miklobit/graffitiRobot/SolidWorksModel/Ensamble.SLDASM

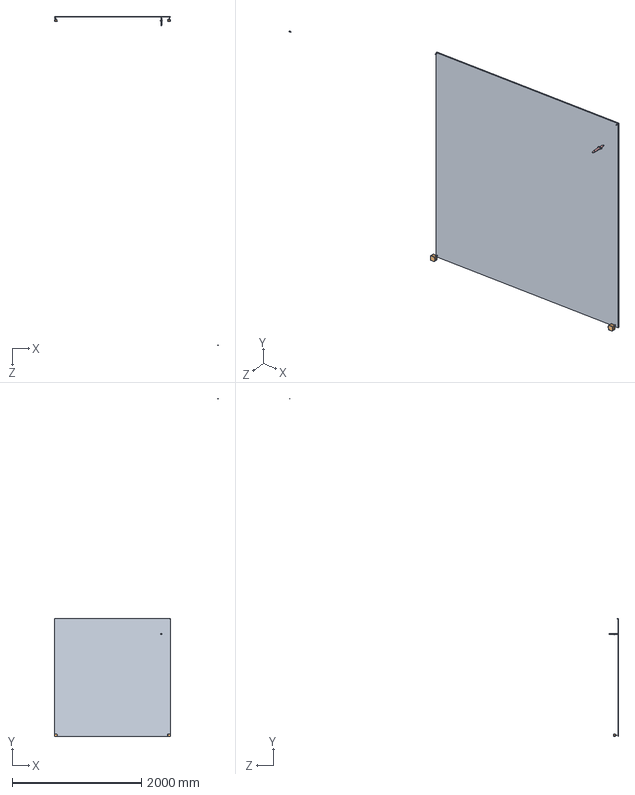
[picture p10: CAD file, 2016-07-19]
SolidWorksModel/Ensamble.SLDASM
2542.7 x 5240.3 x 5101.4 mm
soporte
StepperMotor x 2
Polea x 5
MordazaInferior
marcador
MordazaSuperior
