miklobit/graffitiRobot/SolidWorksModel/Parts/mordazas.SLDASM

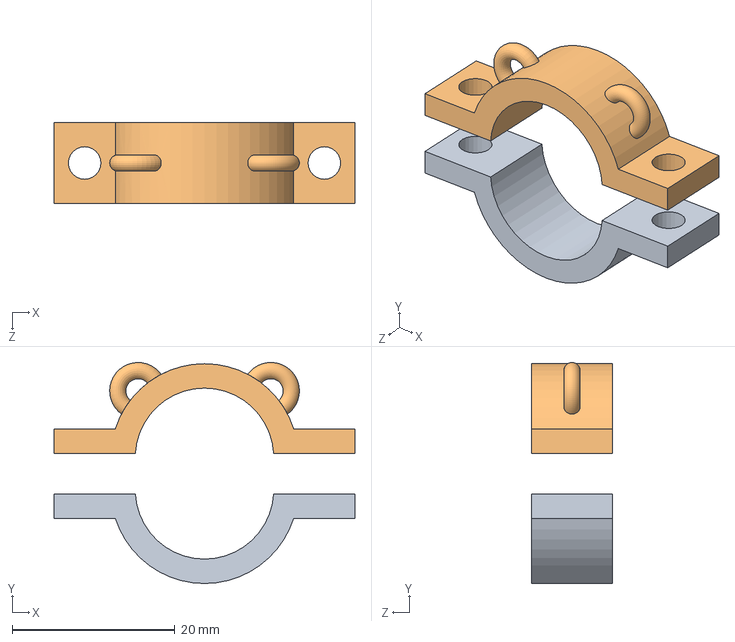
[picture p11: CAD file, 2016-07-18]
SolidWorksModel/Parts/mordazas.SLDASM
37.0 x 27.2 x 10.0 mm
MordazaInferior
MordazaSuperior
