miklobit/graffitiRobot/SolidWorksModel/Parts/soporte.SLDPRT

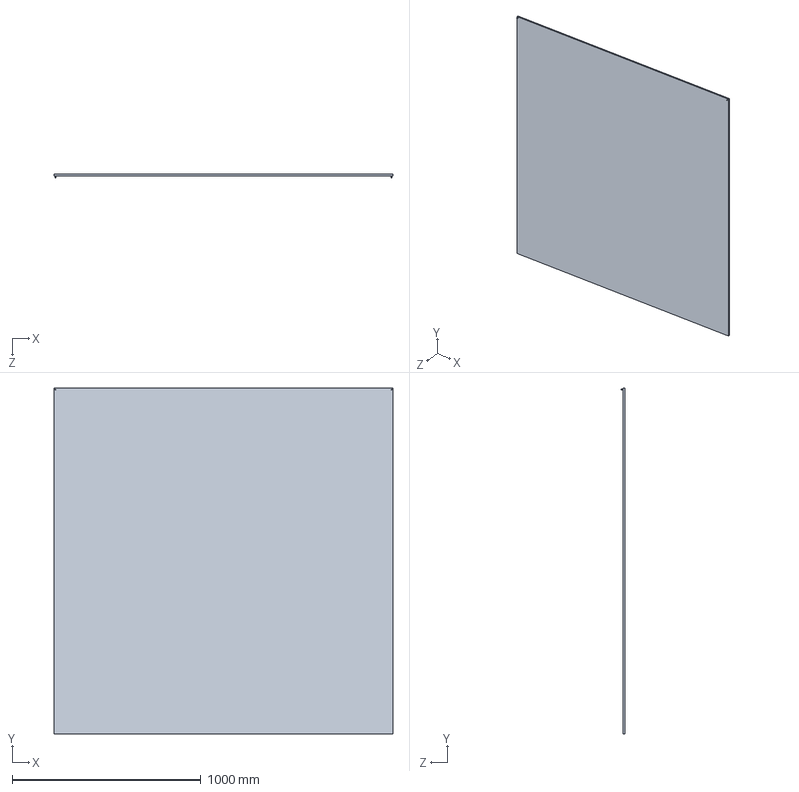
[picture p12: CAD file, 2016-07-15]
SolidWorksModel/Parts/soporte.SLDPRT
1797.8 x 1832.8 x 20.0 mm
