miklobit/graffitiRobot/SolidWorksModel/Parts/Polea.SLDPRT

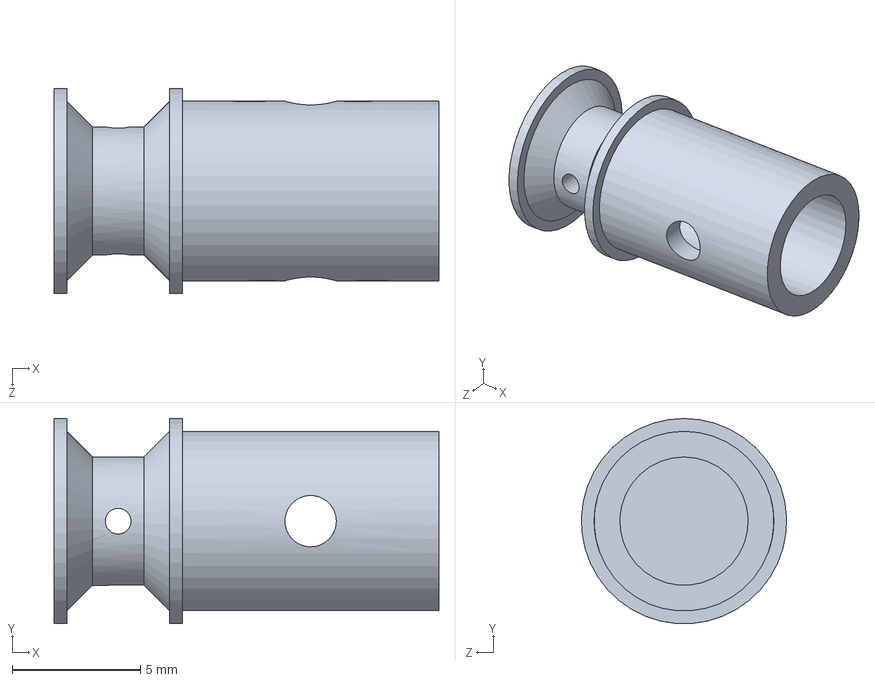
[picture p13: CAD file, 2016-07-15]
SolidWorksModel/Parts/Polea.SLDPRT
15.0 x 7.99 x 7.99 mm
