miklobit/graffitiRobot/SolidWorksModel/Parts/marcador.SLDPRT

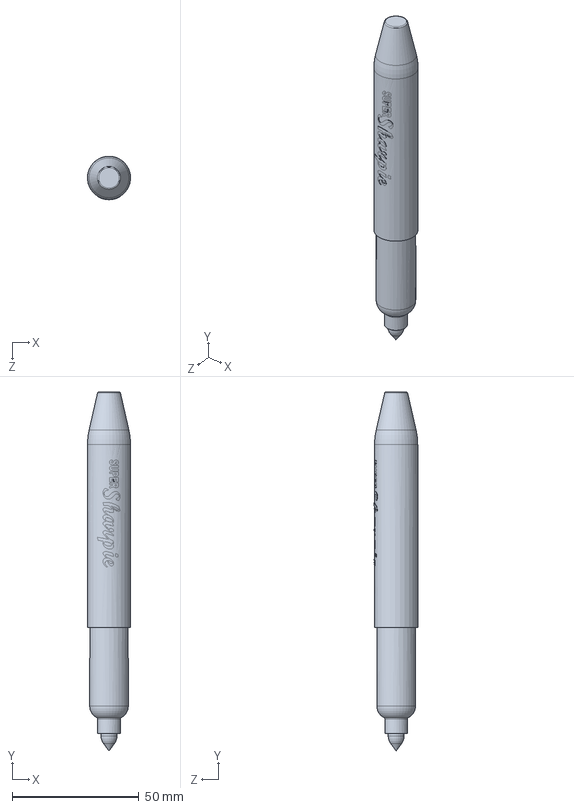
[picture p14: CAD file, 2016-07-15]
SolidWorksModel/Parts/marcador.SLDPRT
17.0 x 141.5 x 17.1 mm
