miklobit/graffitiRobot/SolidWorksModel/Parts/StepperMotor.SLDPRT

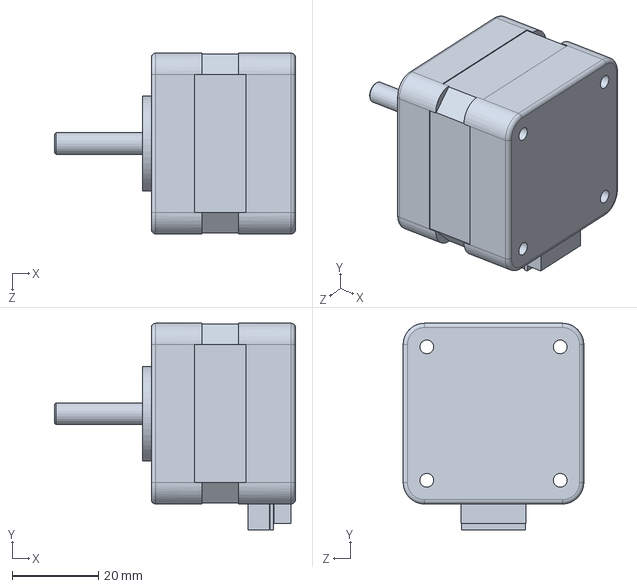
[picture p15: CAD file, 2016-07-15]
SolidWorksModel/Parts/StepperMotor.SLDPRT
56.0 x 48.0 x 42.0 mm
