miklobit/graffitiRobot/SolidWorksModel/Parts/MordazaSuperior.SLDPRT

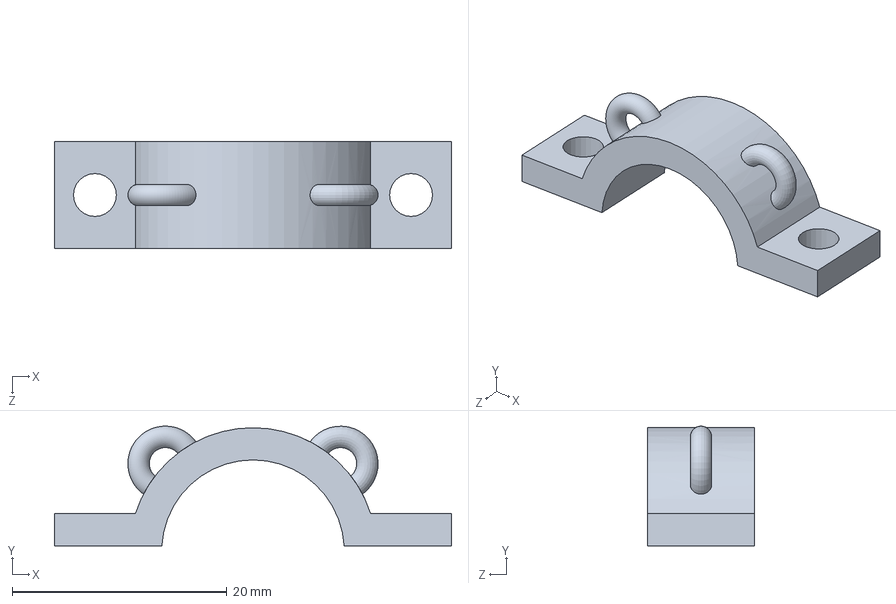
[picture p16: CAD file, 2016-07-15]
SolidWorksModel/Parts/MordazaSuperior.SLDPRT
37.0 x 11.2 x 10.0 mm
