miklobit/graffitiRobot/SolidWorksModel/Parts/MordazaInferior.SLDPRT

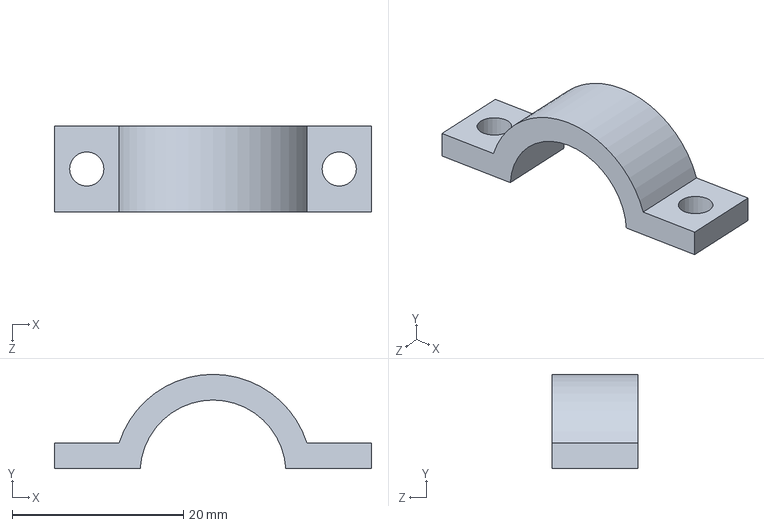
[picture p17: CAD file, 2016-07-15]
SolidWorksModel/Parts/MordazaInferior.SLDPRT
37.0 x 11.0 x 10.0 mm
