miklobit/graffitiRobot/SolidWorksModel/Parts/PK243-01AA Stepper Motor.SLDPRT

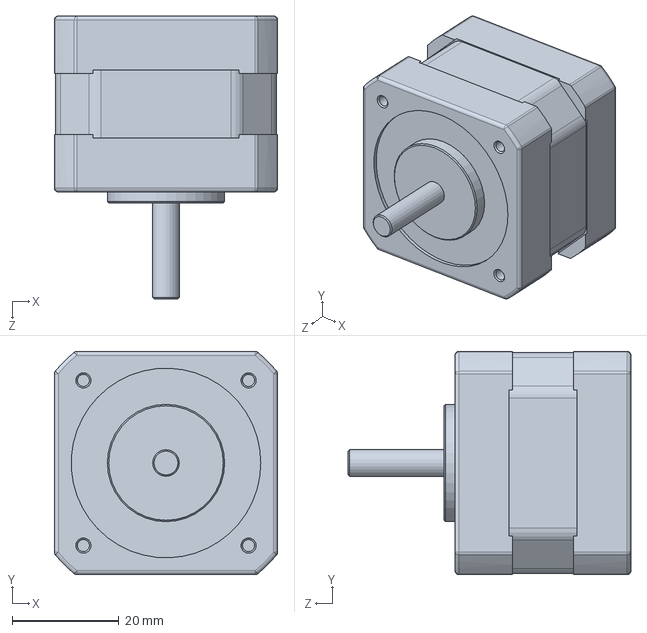
[picture p18: CAD file, 2016-07-15]
SolidWorksModel/Parts/PK243-01AA Stepper Motor.SLDPRT
41.9 x 41.9 x 53.1 mm
