miklobit/graffitiRobot/datasheets/Motor PKP213U05A inner wiring diagram for motor.pdf

PKP213U05A, Stepper Motor
Connection Diagram

PK Series Stepper Motors (0.9°/1.8°) On Oriental Motor U.S.A. Corp. http://catalog.orientalmotor.com/printbrowser?&plpver=1068&prodid...

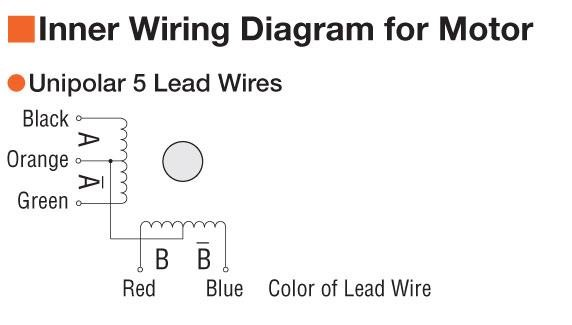
[picture p19: figure]

1 of 1 | 2016-07-09 5:52 PM
