miklobit/graffitiRobot/datasheets/Speed-Torque Characteristics PKP213U05.jpg

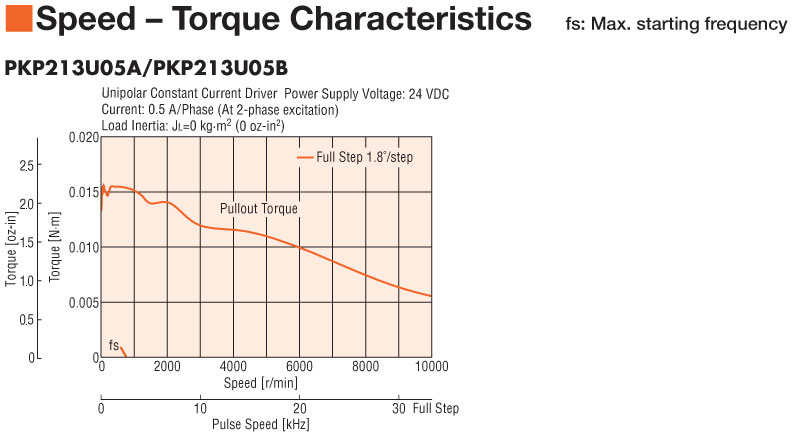
datasheets/Speed-Torque Characteristics PKP213U05.jpg
