miklobit/graffitiRobot/(list of files, drawings)

Other design files:
graffitiRobot.pdsprj
