miklobit/graffitiRobot/PCB/GraffitiRobot.kicad_pcb

## KiCad design PCB/GraffitiRobot.kicad_pcb (2016-07-18)

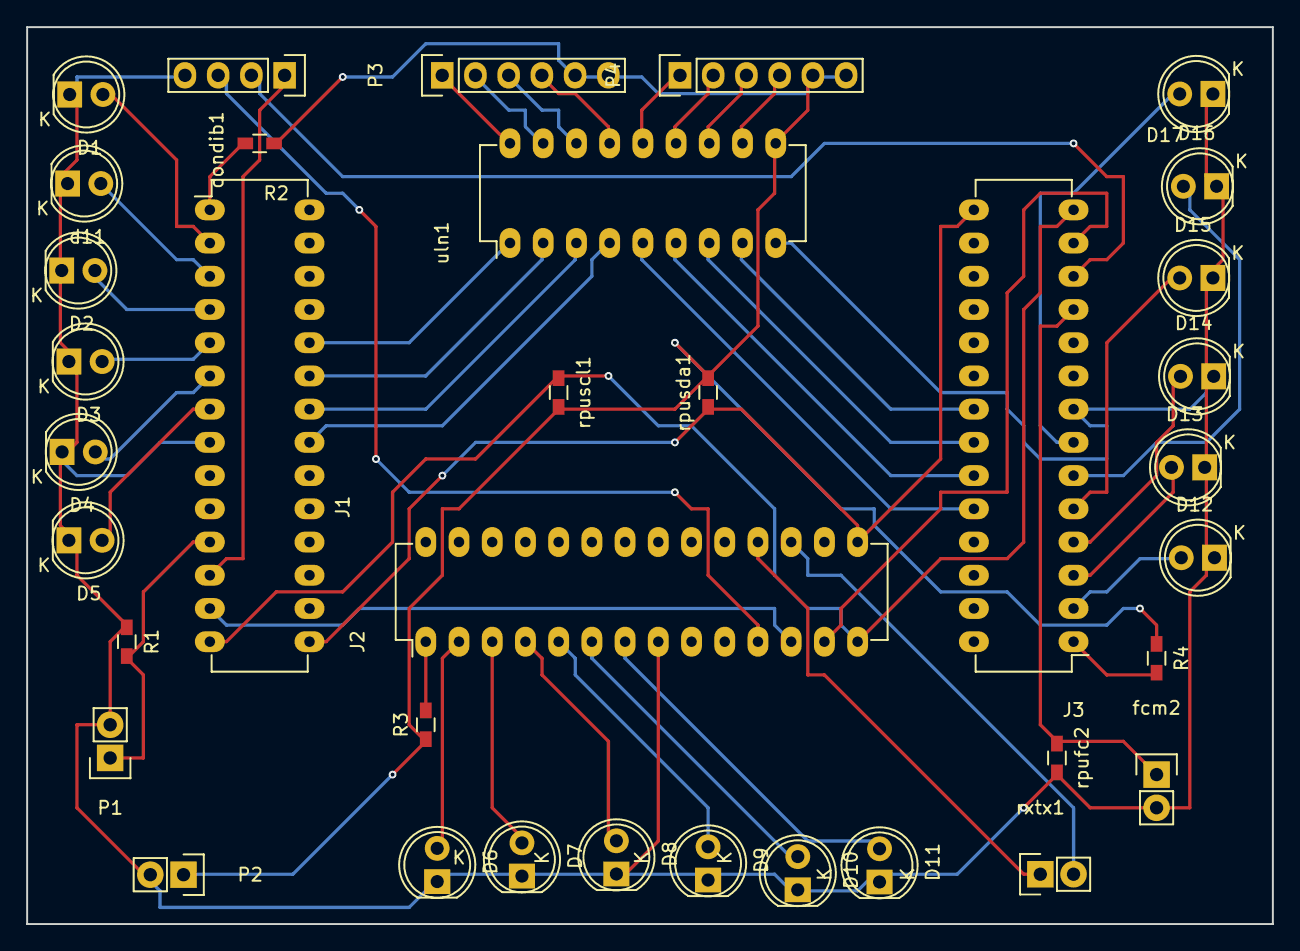
[picture p21: board GraffitiRobot.kicad_pcb from above]

Board: 2 copper layers, 95.2 x 68.6 mm, 36 parts (0 on the bottom side), 50 nets.

Parts:
D1: d11; LED-5MM
D2: d13; LED-5MM
D3: d14; LED-5MM
D4: d15; LED-5MM
D5: d16; LED-5MM
D6: dm1; LED-5MM
D7: dm2; LED-5MM
D8: dm3; LED-5MM
D9: dm4; LED-5MM
D10: dm5; LED-5MM
D11: dm6; LED-5MM
D12, D13, D14, D15, D16, D17: LED; LED-5MM
J1: slave1; DIP-28_W7.62mm_LongPads
J2: masteer; DIP-28_W7.62mm_LongPads
J3: slave2; DIP-28_W7.62mm_LongPads
P1, P2: CONN_01X02; Pin_Header_Straight_1x02
P3: pap1; Pin_Header_Straight_1x06
P4: pap2; Pin_Header_Straight_1x06
R1: R; R_0603_HandSoldering
R2: rpusl1; R_0603_HandSoldering
R3: rpum; R_0603_HandSoldering
R4: rpusl2; R_0603_HandSoldering
condib1: conndib; Pin_Header_Straight_1x04
d11: d12; LED-5MM
fcm2: fcm2; Pin_Header_Straight_1x02
rpufc2: rpufc2; R_0603_HandSoldering
rpuscl1: rpuscl; R_0603_HandSoldering
rpusda1: rpusda; R_0603_HandSoldering
rxtx1: rtmaster; Socket_Strip_Straight_1x02
uln1: uln; DIP-18_W7.62mm_LongPads

Connections:
unnamed: D1.1, D2.1, D3.1, D4.1, D5.1, D6.1, D7.1, D8.1, D9.1, D10.1, D11.1, D12.1, D13.1, D14.1, D15.1, D16.1, D17.1, J1.8, J2.8, J3.8, P1.2, P2.2, R1.1, condib1.4, d11.1, fcm2.2, rpufc2.2, uln1.9
unnamed: D1.2, J1.2
unnamed: D2.2, J1.4
unnamed: D3.2, J1.5
unnamed: D4.2, J1.6
unnamed: D5.2, J1.7
unnamed: D6.2, J2.2
unnamed: D7.2, J2.3
unnamed: D8.2, J2.4
unnamed: D9.2, J2.5
unnamed: D10.2, J2.6
unnamed: D11.2, J2.7
unnamed: D12.2, J3.2
unnamed: D13.2, J3.3
unnamed: D14.2, J3.4
unnamed: D15.2, J3.5
unnamed: D16.2, J3.6
unnamed: D17.2, J3.7
unnamed: J1.1, R2.2
unnamed: J1.3, d11.2
unnamed: J1.11, P1.1, R1.2
unnamed: J1.12, condib1.1
unnamed: J1.13, J2.12
unnamed: J1.14, J2.14, J3.14, rpuscl1.1
unnamed: J1.15, J2.15, J3.15, rpusda1.1
unnamed: J1.21, uln1.4
unnamed: J1.22, uln1.3
unnamed: J1.23, uln1.2
unnamed: J1.24, uln1.1
unnamed: J2.1, R3.2
unnamed: J2.11, condib1.3
unnamed: J2.13, J3.13
unnamed: J2.17, rxtx1.2
unnamed: J2.18, rxtx1.1
unnamed: J3.1, R4.2
unnamed: J3.11, fcm2.1, rpufc2.1
unnamed: J3.12, condib1.2
unnamed: J3.21, uln1.8
unnamed: J3.22, uln1.7
unnamed: J3.23, uln1.6
unnamed: J3.24, uln1.5
unnamed: P2.1, P3.5, P3.6, P4.5, P4.6, R2.1, R3.1, R4.1, rpuscl1.2, rpusda1.2, uln1.10
unnamed: P3.1, uln1.18
unnamed: P3.2, uln1.17
unnamed: P3.3, uln1.16
unnamed: P3.4, uln1.15
unnamed: P4.1, uln1.14
unnamed: P4.2, uln1.13
unnamed: P4.3, uln1.12
unnamed: P4.4, uln1.11
