miklobit/graffitiRobot/graffitiRobotSlave/graffitiRobotSlave.c

#include "C:\Users\Nahuel\Documents\GitHub\microcontroladores\graffitiRobot\graffitiRobotSlave\graffitiRobotSlave.h"

/*****************************************************************************/
/**********************        Variables Globales        *********************/

/** Variables de estado **/
unsigned int8 estado;                                            //variable de estado del master
unsigned int8 estadoAnterior;                                    //variable que lleva el registro del estado anterior del master

/** Variables para comunicación I2C**/
byte fstate;                                                    //Guardara el estado del bus I2C
char orden;
int8 numero1;
int8 numero2;

/** Variables para cotrol del robot**/
// #define Fclock 20000000 //Frecuencia del oscilador	20MHz
// #define Fcy Fclock/4    //Frecuencia Interna 		5MHz
// #define T1pre   1       //Prescaler Timer1
// #define fTimer1	Fcy/T1pre //Freciencia Timer1 		5MHz
// #define tTimer1_NS	1000000000/fTimer1 //Periodo del Timer1 en nseg	200 nseg

#define OVERHEAD 50	//VERIFICAR?
// #define PASORAPIDO_NS 30000
// #define PASOHOMING_NS 150000
// #define PASOFINHOMING_NS 600000

/*-Variables de control de la interrupcion del timer-*/
unsigned int16 timerCarga;
// int16 tt1 = 200;//(int16)(1000000000/((20000000/4)/T1pre));
// int16 tPasoRapido = (int16)(30000/tt1);
// int16 tPasoHoming = (int16)(150000/tt1);
// int16 tPasoFinHoming = (int16)(600000/tt1);

int16 pasoRapido = 0xFFFF - OVERHEAD - 0x064E;          //velocidad máxima de avance del motor (1 paso cada 807 us -> 61500)
int16 homingVel = 0xFFFF - OVERHEAD - 0x27E6;           //velocidad para realización del homing (1 paso cada 5.107 ms -> 40000)
int16 finHomingVel = 0xFFFF - OVERHEAD - 0x5DC0;		//velocidad para terminar el homing (1 paso cada 12ms -> 5535)
/*-Variables de control de pasos-*/
const int8 STEP[] = {0x01,0x03,0x02,0x06,0x04,0x0C,0x08,0x09};    //valores para el puerto de salida de los pasos
unsigned int stepIndex;                                            //apuntador al paso actual
int16 posicionActual;                                    //variable que cuenta los pasos - representa posicion actual
int16 posicionObjetivo;                                    //variable que representa la posiçion objetivo

/*****************************************************************************/
/***************** FUNCION PARA SETEO DE LA POSICION OBJETIVO ****************/
/**                 recibe dos int8 y los agrupa en un int16                **/
void setObjetivo(unsigned int8 numero1, unsigned int8  numero2)
{
	int16 mayor = numero1;
	mayor = 0xFF00 & (mayor << 8);
	int16 menor = 0x00FF & numero2;
    posicionObjetivo = mayor + menor; 
}
/*****************************************************************************/
/********* FUNCION PARA SETEO DEL TIEMPO DE INTERRUPCION DEL TIMER 1 *********/
/**                 recibe dos int8 y los agrupa en un int16                **/
void setTimer(unsigned int8 numero1, unsigned int8  numero2)
{
	int16 mayor = numero1;
	mayor = 0xFF00 & (mayor << 8);
	int16 menor = 0x00FF & numero2;
    timerCarga = mayor + menor; 
}   

/*****************************************************************************/
/********************** FUNCION INTERPRETA COMANDOS I2C *********************/
/**        interpreta los comandos contenidos en la cadena comando[]        **/

void interpreta()
{
    switch(orden)
    {
        case 'p':
        case 'P':
            switch(numero1)
            {
                case 0x00:
                    estadoAnterior = estado;
                    estado = 0x00;
                    break;
                case 0x01:
                    if (estado == 0x00)
                    {
                        estadoAnterior = estado;
                        estado = 0x01;
                    }
                    break;
            }
            break;
        case 'h':
        case 'H':
            switch(numero1)
            {
                case 0x00:
                    if (estado == 0x01)
                    {
                        estadoAnterior = estado;
                        estado = 0x09;
                    }
                    else if (estado == 0x05)
                    {
                        estadoAnterior = estado;
                        estado = 0x0F;
                    }
                    break;
                case 0x01:
                    estadoAnterior = estado;
                    estado = 0x0B;
                    break;
            }
            break;
        case 'x':
        case 'X':
            if (estado == 0x0F)
            {
            	posicionObjetivo = posicionActual;
                estadoAnterior = estado;
                estado = 0x05;
            }
            else
            {
            	estadoAnterior = estado;
                estado = 0x01;
            }
            break;
        case 'm':
        case 'M':
            if (estado == 0x05)	
            {
                setObjetivo(numero1, numero2);    
                estadoAnterior = estado;
                estado = 0x0D;
            }
            break;
        case 't':
        case 'T':
            if (estado == 0x05)
            {
                setTimer(numero1, numero2);    
                estadoAnterior = estado;
                estado = 0x15;
            }
            break;
        case 'd':
        case 'D':
            if (estado == 0x15)
            {
                setObjetivo(numero1, numero2);       
                estadoAnterior = estado;
                estado = 0x2D;
            }
            break;
    }
}

#int_TIMER1
void  TIMER1_isr(void) 
{
    set_timer1(timerCarga);                            //recarga del timer
    if (posicionObjetivo < posicionActual)            //si la posicion actual es mayor a la objetivo, decremento el indice y la posicion actual
    {
        posicionActual--;
        if(stepIndex == 0)                            //verifico no exceder el limite inferior de valores posibles del indice
            stepIndex = 7;
        else
            stepIndex--;                            
    }
    else if (posicionObjetivo > posicionActual)        //si la posicion actual es inferior a la objetivo, incremento el indice y la posicion actual
    {
        posicionActual++;
        if(stepIndex == 7)                            //verifico no exceder el limite superor de los valores posibles del indice
            stepIndex = 0;
        else
            stepIndex++;
    }
    output_B(STEP[stepIndex]);                        //actualizo el puerto que actua sobre el motor
}

/******************************************************************************/
/***************** FUNCIÓN INTERRUPCIÓN POR RECEPCION I2C *********************/
/**  Saltará a esta función cada vez que se detecte actividad en el bus I2C  **/

#int_SSP
void  SSP_isr(void) 
{
    int incoming;                            //Variable donde se recibe el byte que manda el maestro
    fstate = i2c_isr_state();                //Lectura del estado del bus I2c la interrupción
    /* Solicitud de lectura del esclavo por el master */
    if(fstate == 0x80) {         
        i2c_write(estado);                    //Manda al maestro el estado del esclavo
    }
    /* Sino está solicitando lectura es que está enviando algo */
    else {                                    //Sino es que hay dato en el bus I2C...
        incoming = i2c_read();                //... lo lee
        if (fstate == 1) {                    //Información recibida corresponde a la orden
            orden = incoming;                //Se guarda posición
        }
        else if (fstate == 2) {                //Información recibida corresponde a la primera opcion de la orden
            numero1 = incoming;                //Se guarda dato
        }
        else if (fstate == 3) {                //Información recibida corresponde a la segunda opcion de la orden
            numero2 = incoming;                //Se guarda dato
            interpreta();
        }
    }
}



void main()
{
    set_tris_A(0x00);
    set_tris_B(0x00);
    bit_set(TRISC,0);    //RC0 entrada
    bit_set(TRISC,1);    //RC1 entrada
    bit_clear(TRISC,2);    //RC2 salida
    bit_set(TRISC,5);    //RC5 entrada

    bit_clear(PORTC,2);    //RC2=0

    estado = 0x00;                //Representa el estado del master
    estadoAnterior = 0x01;        //Definido con un valor diferente a estado solo a fines de que pase por el primer bucle de desenergizado
    
    stepIndex = 0;

    setup_adc_ports(NO_ANALOGS|VSS_VDD);    
    setup_adc(ADC_CLOCK_DIV_2);
    setup_timer_0(RTCC_INTERNAL|RTCC_DIV_1);
    setup_timer_1(T1_INTERNAL|T1_DIV_BY_1);
    setup_timer_2(T2_DISABLED,0,1);
    setup_comparator(NC_NC_NC_NC);// This device COMP currently not supported by the PICWizard
    enable_interrupts(INT_TIMER1);
    enable_interrupts(INT_SSP);
    enable_interrupts(GLOBAL);
//Setup_Oscillator parameter not selected from Intr Oscillator Config tab
	setup_oscillator( OSC_8MHZ ); 

    if(input(PIN_C5)==1){
        SSPADD = 0x10;
    }
    else if(input(PIN_C5)==0){
        SSPADD = 0x20;
    }        
    
    for (;;)
    {
        switch(estado)
        {
            case 0x00:              //Desenergizar motor
                if(estadoAnterior & 0x01)    //antes estaba energizado
                {
                    //Actualiza variables de estado
                    estadoAnterior = 0x00;
                    output_A(estado);
                    //Actualiza variables de control del motor
                    disable_interrupts(INT_TIMER1);
                    output_B(0x00);
                }
                output_high(PIN_A0);
				delay_ms(60);
				output_low(PIN_A0);
				delay_ms(60);
                break;
            case 0x01:              //Energizar motor
                //Actualiza variables de estado
                output_A(estado);
                //Actualiza variables de control del motor
                disable_interrupts(INT_TIMER1);
                output_B(STEP[stepIndex]);
                break;
            case 0x0B:              //Hacer homing
                output_A(estado);
                output_high(PIN_C2);                                //informo que estoy ocupado
                //BUSCANDO FIN DE CARRERA
                timerCarga = homingVel;
                set_timer1(timerCarga);                    //Seteo la interrupcion del timer en una velocidad moderada
                posicionObjetivo = 10;
                enable_interrupts(INT_TIMER1);            //habilito la interrupcion del timer
                while(input(PIN_C0) == 0)                //mientras no reciba una señal del fin de carrera para homing
                {                        
                    posicionActual = 100;                //actualizo la posicion actual siempre superior a la posicion objetivo para que en la interrupcion se retroceda
                }
                //SEPARANDOSE DEL FIN DE CARRERA
                timerCarga = finHomingVel;                    //seteo la interrupcion del timer en una velocidad lenta
                posicionObjetivo = 100;
                while(input(PIN_C0) == 1)                        //mientras el fin de carrera hace contacto
                {
                    posicionActual = 10;                    //actualiza la posicion actual a un valor inferior a la posición objetivo para que avance lentamente
                }
                //FIN DEL HOMING
                posicionActual = 0;                        //defino el origen
                posicionObjetivo = 0;                    //no tengo un objetivo nuevo
                estadoAnterior = 0x0B;
                estado = 0x05;                            //paso a estado de reposo, ya referenciado
                break;
            case 0x09:              //avanzando ciego para permitir al otro robot hacer el homing
                //Actualiza variables de estado
                output_A(estado);
            
                //Actualiza variables de control del motor
                //AVANZANDO
                timerCarga = homingVel;
                set_timer1(timerCarga);                    //Seteo la interrupcion del timer en una velocidad moderada
                posicionObjetivo = 100;
                enable_interrupts(INT_TIMER1);            //habilito la interrupcion del timer
                
                //Loop para desplazarce hasta que el master indique detenerse (orden 'X')
                while(estado == 0x09){                    //mientras no reciba una mensaje del master de cambiar de estado, dejar de avanzar
                    posicionActual = 10;                //actualizo la posicion actual siempre superior a la posicion objetivo para que en la interrupcion avance
                }
                break;
            case 0x0F:              //avanza para permitir al otro motor hacer homing, sin perder la referencia
                //Actualiza variables de estado
                output_A(estado);

                //Actualiza variables de control del motor
                //AVANZANDO
                timerCarga = homingVel;
                set_timer1(timerCarga);                    //Seteo la interrupcion del timer en una velocidad moderada
                posicionObjetivo = posicionActual + 50;    //pongo un objetivo 'adelante' de la posicion actual
                enable_interrupts(INT_TIMER1);            //habilito la interrupcion del timer

                //Loop para desplazarce hasta que el master indique detenerse (orden 'X')
                while(estado == 0x0F){                    //mientras no reciba una mensaje del master de cambiar de estado, dejar de avanzar
                    posicionObjetivo = posicionActual + 50;                //actualizo la posicion actual siempre superior a la posicion objetivo para que en la interrupcion avance
                }
                break;
            case 0x05:
            case 0x15:                                //Estado de reposo, energizado y referenciado
                if (estadoAnterior & 0x08)    //anteriormente se estaba moviendo
                {
                    //Actualiza variables de estado
                    estadoAnterior = estadoAnterior & 0xEF;	//pongo a 0 el bit que indica movimiento
                    output_low(PIN_C2);                                //informo que estoy desocupado
                    output_A(estado);

                    //Actualiza variables de control del motor
                    disable_interrupts(INT_TIMER1);
                }
                break;
            case 0x0D:
                //Actualiza variables de estado
                output_A(estado);
                output_high(PIN_C2);                                //informo que estoy ocupado

                //Actualiza variables de control del motor
                timerCarga = pasoRapido;
                set_timer1(timerCarga);
                enable_interrupts(INT_TIMER1);
                
                //Loop hasta llegar a la posición objetivo
                while(estado == 0x0D)    //el bucle no es while(posicionActual!=posicionObjetivo) para permitir cortar el avance con la orden 'X'
                {
	                if (posicionActual == posicionObjetivo)
                        break;
                }
                estadoAnterior = 0x0D;
                estado = 0x05;
                break;
            case 0x2D:
                //Actualiza variables de estado
                output_A(estado);

                while(input(PIN_C1) == 0){	//Espera a que el dispositivo de escritura sea accionado
                }

                //Actualiza variables de control del motor
                enable_interrupts(INT_TIMER1);

                output_high(PIN_C2);                                //informo que estoy ocupado
                
                //Loop hasta llegar a la posición objetivo
                while((estado == 0x2D) && (input(PIN_C1)==1))    //el bucle no es while(posicionActual!=posicionObjetivo) para permitir cortar el avance con la orden 'X'                {
                {
	                if (posicionActual == posicionObjetivo)
                        break;
                }
                estadoAnterior = 0x2D;
                estado = 0x05;
                break;
        }
    }
}
