miklobit/graffitiRobot/(commit log)

2016-07-06 Proteus project created
    [graffitiRobot.pdsprj]
2016-07-07 proteus circuit done
    [graffitiRobot.pdsprj]
2016-07-08 UART tested
    [graffitiRobot.pdsprj]
2016-07-09 I2C working - energized and de-enrgized
    [graffitiRobot.pdsprj]
2016-07-10 homing tested
    [graffitiRobot.pdsprj, velocidades del motor.ods]
2016-07-15 Control de Posicion Implementado
    [Ensamble.SLDASM, MordazaInferior.SLDPRT, MordazaSuperior.SLDPRT, PK243-01AA Stepper Motor.SLDPRT, Polea.SLDPRT, StepperMotor.SLDPRT, calculo de coordenadas e interrupcion de timer.ods, graffitiRobot.pdsprj]
2016-07-15 ensamble solidworks del sistema
    [Ensamble.SLDASM, soporte.SLDPRT]
2016-07-16 actualizacion de constantes para las consideraciones geometricas
2016-07-18 desarrollo de PCB
    [GraffitiRobot-B.Cu.gbl, GraffitiRobot-B.Mask.gbs, GraffitiRobot-B.SilkS.gbo, GraffitiRobot-Edge.Cuts.gm1, GraffitiRobot-F.Cu.gtl, GraffitiRobot-F.Mask.gts, GraffitiRobot-F.SilkS.gto, GraffitiRobot-drl_map.gbr]
2016-07-19 informe added
    [Ensamble.SLDASM]
2016-08-03 Version final
    [graffitiRobot.pdsprj]
